ionutes/Amplificator_de_tensiune/Documentatie_P1_CEF_Dragotoniu_431C.pdf

# PROIECT 1 CIRCUITE ELECTRONICE FUNDAMENTALE

# AMPLIFICATOR DE TENSIUNE

# CU REACȚIE

PROFESORI COORDONATORI: Ș. I. Dr. Ing. Miron Jean Cristea

Dr. Ing. Niculina Drăghici

## STUDENT: DRAGOTONIU IONUȚ-CONSTANTIN

## GRUPA 431C

## CUPRINS

1. Tema proiectul | pag. 3
2. Schema bloc | pag. 3
3. Schema electrica | pag. 4
4. Detalii de proiectare | pag. 4
4.1. Etajul diferential | pag. 6
4.2. Etajul emitor comun degenerat | pag. 6
4.3. Etajul de iesire in clasa AB | pag. 7
4.4. Sursa de curent | pag. 8
4.5. Oglinda de curent | pag. 8
5. Functionalitatea circuitului | pag. 9
6. Punctul static de functionare | pag. 10
7. Amplificarea in bucla inchisa | pag. 15
8. Amplificarea in bucla deschisa | pag. 16
9. Impedanta de intrare | pag. 18
10. Analiza domeniului temperaturilor de functionare | pag. 19
11. Bill of materials (BOM) | pag. 19
12. Bibliografie | pag. 20

### 1. CERINȚELE PROIECTULUI (pentru N=2):

Obiectivul este proiectarea și realizarea practică a unui amplificator de tensiune cu următorii parametri:

- Câștig în tensiune: Av = 3 +

2
2

= 4

- Semnal intrare: sinusoidă cu amplitudinea de 100mVv-v și frecvența 1kHz .
- Impedanță la intrare: 100kΩ .
- Sarcină la ieșire: rezistență de 10Ω .
- Regim termic: funcționare între 0-70°C (validată prin teste);
- Amplificare în buclă deschisă: valoare minimă de 200;
- Circuitul va fi alimentat la o sursă de tensiune curentă.
- Se folosesc componente discrete, nu se folosesc circuite integrate.

### 2. SCHEMA BLOC A CIRCUITULUI

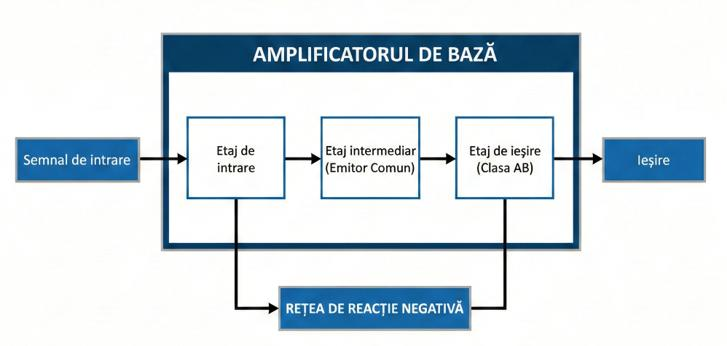
[picture p1: figure]

3.SCHEMA ELECTRICULUI (ÎN BUCLĂ ÎNCHISĂ)

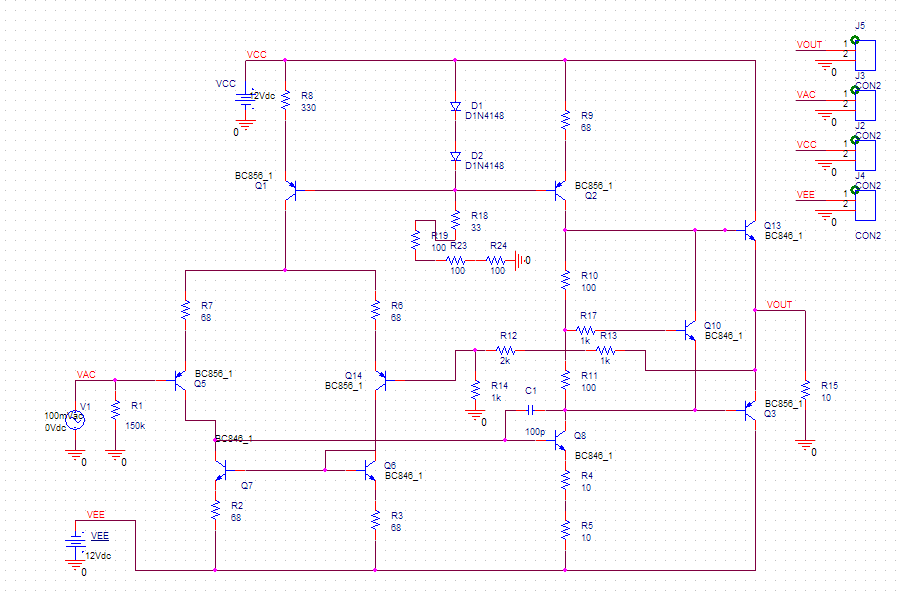
[picture p2: figure]

### 4. DETALII DE PROIECTARE

Circuitul realizat este un amplificator de joasă frecvență cu reacție negativă de tip serie-paralel. Arhitectura generală este compusă din amplificatorul de bază și rețeaua de reacție.

Amplificatorul de bază este structurat, la rândul său, pe trei etaje principale de amplificare:

- Etajul de intrare: realizat cu un amplificator diferențial;
- Etajul intermediar: configurat ca emitor comun degenerat;
- Etajul de ieșire: funcționând în clasa AB.

Pentru asigurarea punctelor statice de funcționare, amplificatorul de bază integrează și două blocuri auxiliare esențiale:

- Sursa de curent;
- Oglinda de curent.

În figura următoare au fost evidențiate toate etajele :

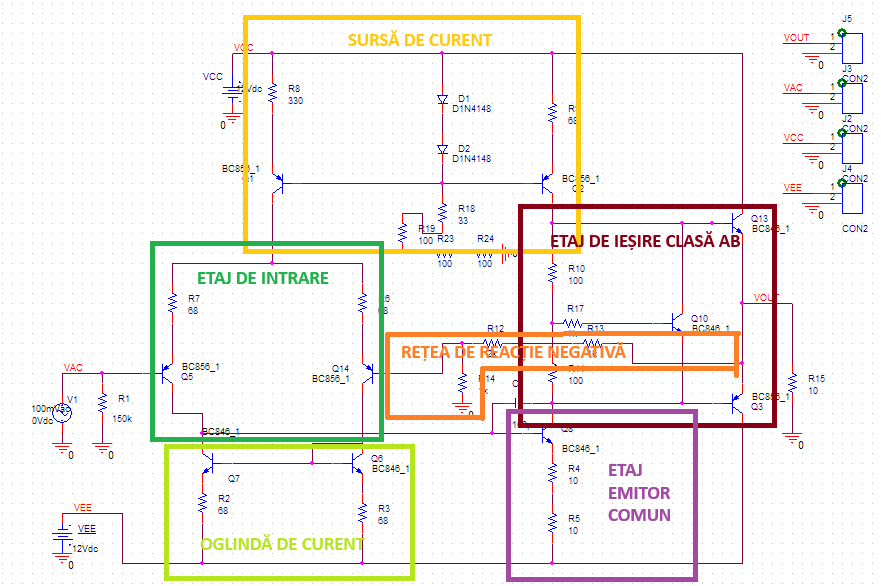
[picture p3: figure]

Mai jos sunt prezentate rolurile pentru fiecare bloc care intră în construcția amplificatorului:

### 4.1. ETAJUL DIFERENȚIAL

Etajul de intrare este configurat sub forma unui amplificator diferențial. Acest montaj electronic utilizează două intrări pentru a procesa și amplifica exclusiv diferența de potențial dintre semnalele aplicate, oferind un câștig ridicat pentru modul diferențial.

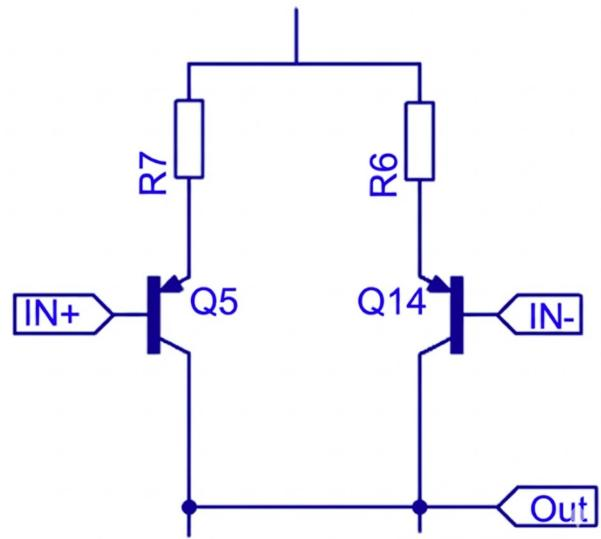
[picture p4: figure]

În schema amplificatorului, etajul diferențial este format din tranzistoarele PNP Q5 și Q14 (de tipul BC856B) și rezistențele de aceeași valoare R6 = R7 = 68 Ohmi. Acest etaj este esențial pentru funcționarea circuitului și, totodată, pentru a ajunge la amplificarea dorită.

Etajul face diferența dintre tensiunea sinusoidală aplicată la intrare (în baza tranzistorului Q5) și semnalul adus în baza tranzistorului Q14 (prin intermediul reacției negative). Acesta realizează o amplificare ridicată în condiții de derivă minimă și un raport semnal-zgomot favorabil.

### 4.2. ETAJUL EMITOR COMUN DEGENERAT

Etajul intermediar este realizat printr-o configurație emitor comun, având rolul de a spori considerabil amplificarea semnalului. Dincolo de câștigul în tensiune, acesta îndeplinește funcția esențială de adaptare între etajul de intrare și blocul de ieșire.

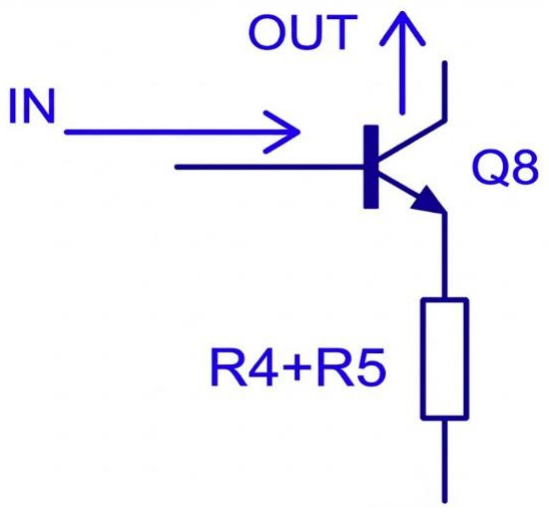
[picture p5: figure]

Etajul este considerat "degenerat" deoarece are legate și rezistențele în serie R4 și R5 de emitorul tranzistorului Q8.

### 4.3. ETAJUL DE IEȘIRE ÎN CLASĂ AB

Configurația de clasă AB a etajului de ieșire este aleasă pentru a contracara ambalarea termică. Tensiunea de polarizare pentru perechea Q13–Q3 este furnizată de tranzistorul Q10, prin multiplicarea tensiunii sale bază-emitor Vbe10.

Din schemă putem observa că:

Vce10 = Vbe13 + Veb3

Dar, în același timp, se formează și un divizor de tensiune în baza tranzistorului Q10. Așadar, se poate scrie că:

Vbe10 = Vce10 * [ R11 / (R10 + R11) ]

Deci:

Vce10 = Vbe10 * (1 + R10/R11)

Din acest motiv am ales rezistențele R10 = R11 egale în circuit, pentru a obține Vce10 = 2 * Vbe10. Astfel, forțăm tranzistoarele Q13 și Q3 să lucreze în RAN (Regim Activ Normal),

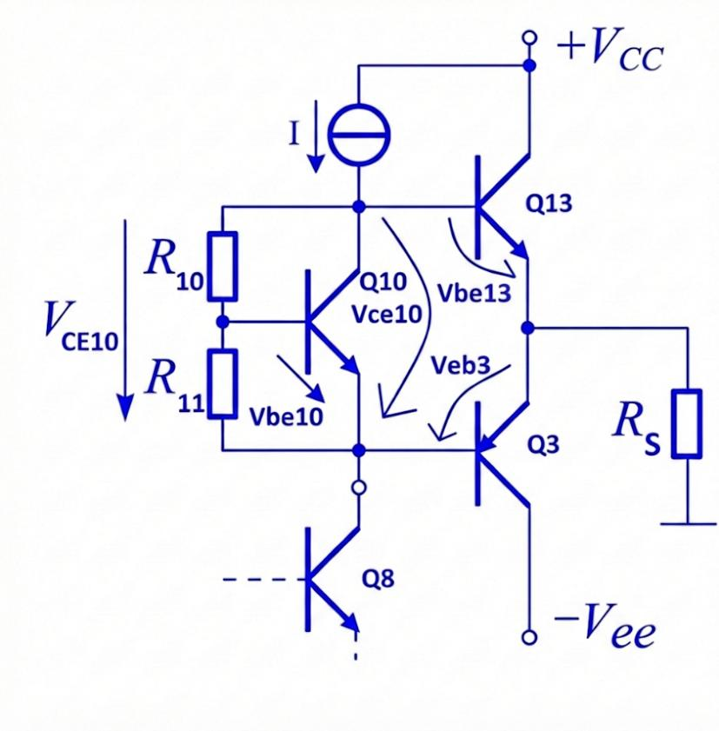
[picture p6: figure]

considerând că tranzistoarele au tensiunile dintre bază-emitor aproximativ egale:

2 * Vbe10 = Vbe13 + Veb3

Evitarea ambalării termice a etajului de la ieșire poate fi demonstrată astfel:

Considerăm că prin tranzistoarele Q13 și Q3 trece curentul IQ, iar prin rezistența de sarcină trece un curent neglijabil în raport cu IQ.

Știm că Vce10 = Vbe13 + Veb3 și că Vce10 = Vbe10 * (1 + R10/R11).

Concluzia matematică arată că, în final, curentul IQ nu va depinde critic de temperatură, ci doar de parametrii de model și rezistențele R10 și R11.

### 4.4. SURSA DE CURENT

Sursa de curent, împreună cu oglinda de curent, asigură echilibrarea etajului diferențial prin forțarea tranzistoarelor Q5 și Q14 să conducă curenți de valori identice.

Ic1 = (2 * Vd - Veb1) / R8

În acest caz, am notat Vd3 = Vd2 = Vd deoarece diodele D1 și D2 sunt de același tip. Totodată, sursa de curent alimentează și etajul intermediar emitor-comun cu ajutorul tranzistorului Q2.

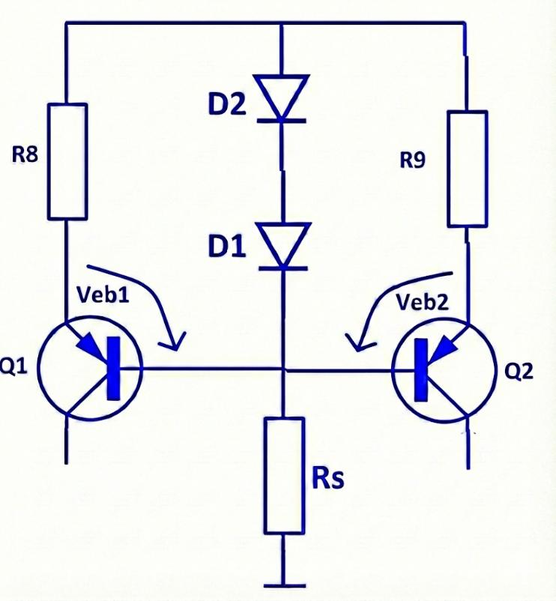
[picture p7: figure]

### 4.5. OGLINDA DE CURENT

Oglinda de curent se definește ca un repetor de curent cu schimbarea punctului de referință al sarcinii.

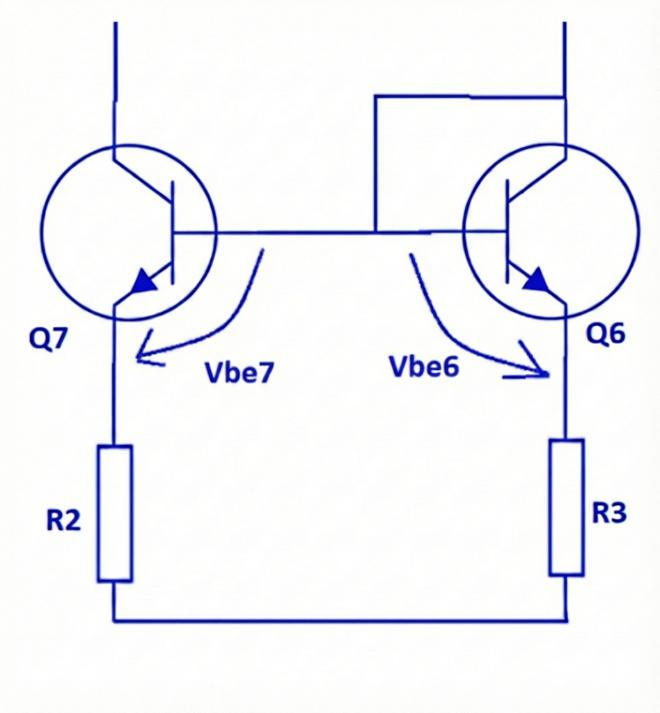
[picture p8: figure]

În schema amplificatorului, oglinda de curent este formată din tranzistoarele Q7 și Q6, care sunt de același tip. Așadar, au aceiași parametri de model, inclusiv curentul de saturație Is7 = Is6.

Dacă tranzistoarele funcționează la aceeași temperatură: Vth7 = Vth6.

Știind în plus că Vbe7 = Vbe6, atunci rezultă că Ic7 = Ic6, deci Ic5 = Ic14, în condițiile în care curenții prin bazele tranzistoarelor sunt neglijabili.

Amplificatorul diferențial împreună cu oglinda de curent oferă performanțe mult mai bune.

### 5. FUNCȚIONALITATEA CIRCUITULUI

La intrarea circuitului se aplică un semnal sinusoidal cu frecvența de 1kHz și o amplitudine vârf-la-vârf de 100mV. Impedanța de intrare este determinată în principal de rezistența R12.

Pentru a respecta cerința de proiectare (o impedanță de intrare de 100 kOhmi), a fost selectată o rezistență de 150 kOhmi. Justificarea acestei alegeri se bazează pe faptul că impedanța totală de intrare este echivalentul paralel dintre R1 și rezistența de intrare în baza
tranzistorului Q5.

Deoarece impedanța în baza lui Q5 este foarte mare (de ordinul MOhmi), contribuția sa în paralel este neglijabilă, valoarea finală fiind dictată practic de R1.

Pentru a asigura o amplificare în buclă deschisă de peste 200, s-au ales tensiuni de alimentare de ±12V.
Polarizarea etajului de intrare

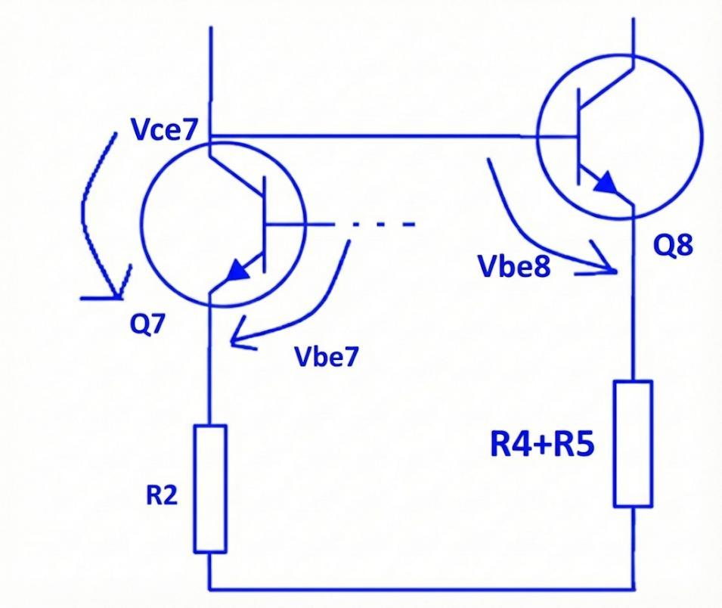
[picture p9: figure]

este realizată prin sursa de curent Q1, care impune curenți egali și constanți prin tranzistoare: Ic5 = Ic14 = 1.4 mA.

Tranzistoarele Q7 și Q6 formează o oglindă de curent, având rolul de a forța egalitatea curenților din etajul diferențial. Pentru menținerea tranzistoarelor Q5 și Q14 în Regiunea Activă Normală (RAN), sunt utilizate diodele D1 și D2.

După etajul diferențial cu ieșire asimetrică, semnalul trece într-un etaj de tip emitor comun degenerat, construit în jurul tranzistorului NPN Q8.

Curentul de colector al acestuia (12.8mA) este furnizat de o a doua sursă de curent, realizată cu tranzistorul PNP Q2.

Pentru a garanta funcționarea lui Q7 în RAN (condiția Vce7 ≥ Vbe7), este necesară o rezistență care să producă o cădere de tensiune; fără aceasta, condiția nu ar putea fi îndeplinită. Ecuația pentru acest ochi de rețea este Vce7+Vr2=Vbe8+Vr4+Vr5.

Etajul final este de clasă AB, fiind compus din tranzistoarele Q13 și Q3, prin care circulă curenți de repaus Ic13 = 6.9 mA și Ic3 = 6.9 mA. Polarizarea acestora este asigurată de tranzistorul Q10 împreună cu rezistențele R10 și R11; Q10 funcționează ca un multiplicator de tensiune bază-emitor și nu participă activ la amplificarea semnalului.În ansamblu, cele trei etaje descriu arhitectura internă a unui amplificator operațional.

Circuitul este stabilizat printr-o buclă de reacție negativă formată din R12, R13 și R14, care preia semnalul de la ieșire și îl reintroduce la intrarea amplificatorului (în baza lui Q14).

A=1+(R12+R13)/R14

### 6. PUNCTUL STATIC DE FUNCȚIONARE

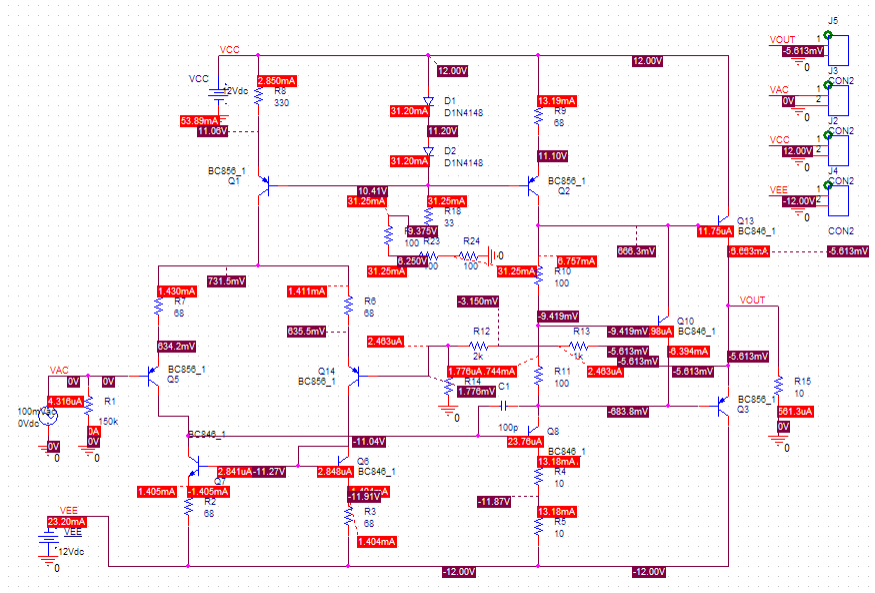
[picture p10: figure]

Q5 (Intrare): Vec5 = 10.6 V ≥ Veb5 => Q5 este în RAN
- Veb5 = 0.65V
- Ic5 = 1.4 mA
Q14 (Intrare): Vec14 = 10.6 V ≥ Veb14 => Q14 este în RAN
- Veb14 = 0.6V
- Ic14 = 1.37 mA
Q7 (Oglindă): Vce7 = 0.88 V ≥ Vbe7 => Q7 este în RAN

- Vbe7 = 0.66V
- Ic7 = 1.37 mA
Q6 (Oglindă): Vce6 = 0.65 V ≥ Vbe6 => Q6 este în RAN
- Vbe6 = 0.66V
- Ic6 = 1.36 mA
Q1 (Sursă): Vec1 = 9.3 V ≥ Veb1 => Q1 este în RAN
- Veb1 = 0.66V
- Ic1 = 2.8 mA
Q8 (EMC): Vce8 = 10 V ≥ Vbe8 => Q8 este în RAN
- Vbe8 = 0.7V
- Ic8 = 12.8 mA
Q2 (Sursă): Vec2 = 9.4 V ≥ Veb2 => Q2 este în RAN
- Veb2 = 0.7V
- Ic2 = 12.8 mA
Q13 (Ieșire): Vce13 = 11 V ≥ Vbe13 => Q13 este în RAN
- Vbe13 = 0.68V
- Ic13 = 6.9 mA
Q3 (Ieșire): Vec3 = 11 V ≥ Veb3 => Q3 este în RAN
- Veb3 = 0.68V
- Ic3 = 6.9 mA
Q10 (Ieșire): Vce10 = 1.36V ≥ Vbe10 => Q10 este în RAN
- Vbe10 = 0.68V
- Ic10 = 5.9 mA

Rezultatele simulării indică faptul că intensitatea curenților de bază este neglijabilă, având valori extrem de scăzute. Totodată, prin determinarea Punctului Static de Funcționare (PSF), am confirmat că parametrii operaționali ai fiecărei componente se încadrează în limitele de siguranță specificate în fișele tehnice (datasheets).
Exemplu de limite determinate din foile de catalog:

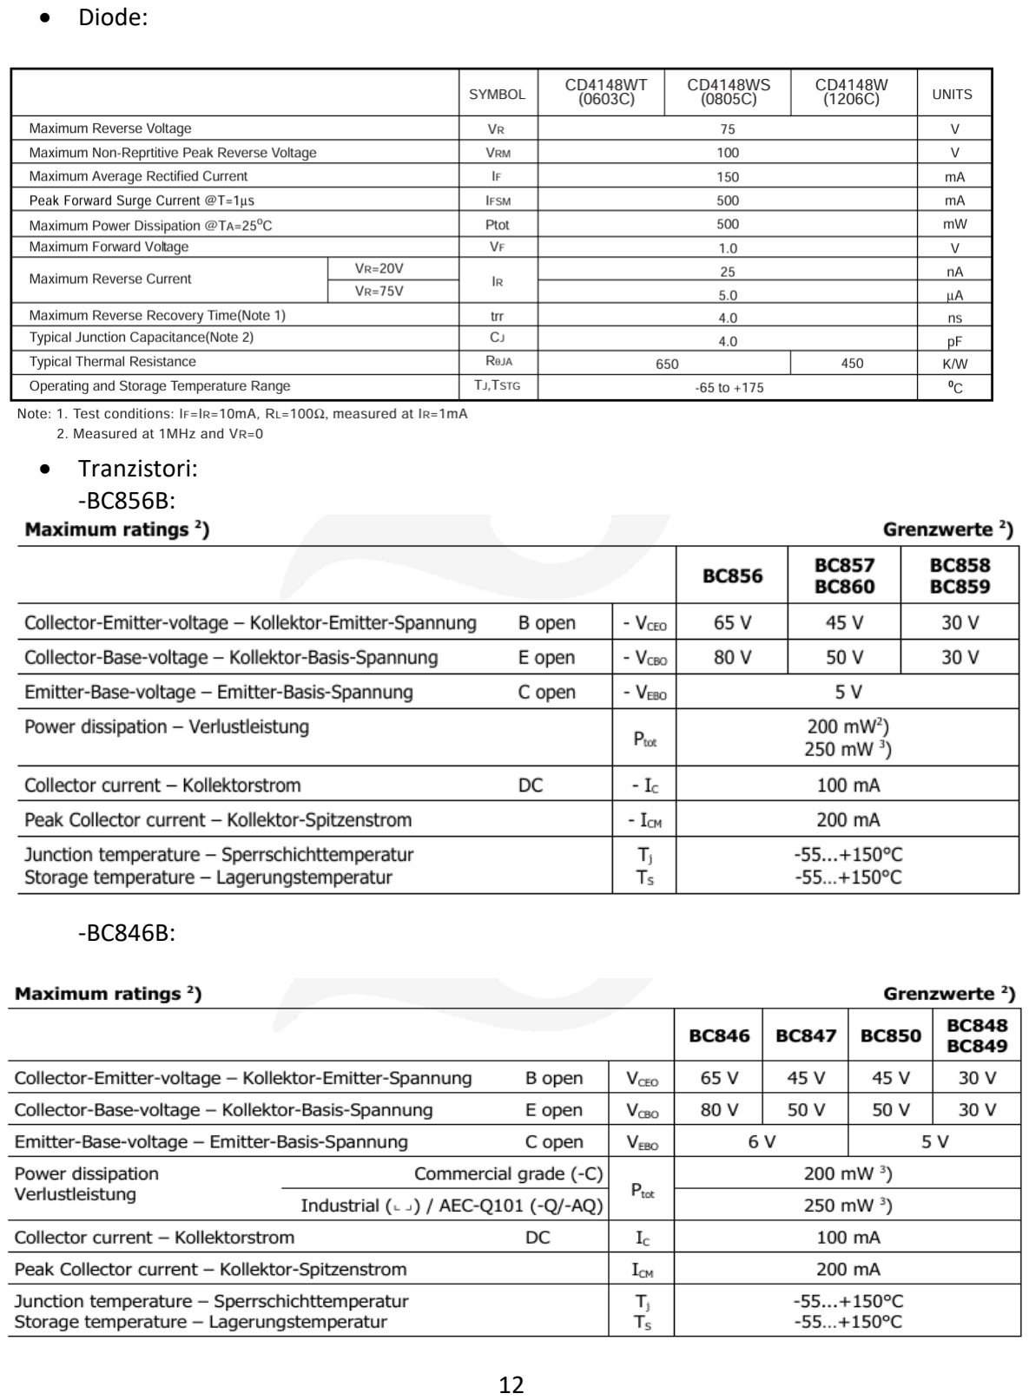
[picture p11: page 12]

- Diode:
- Tranzistori:
-BC856B:

-BC846B:

- REZISTENȚE

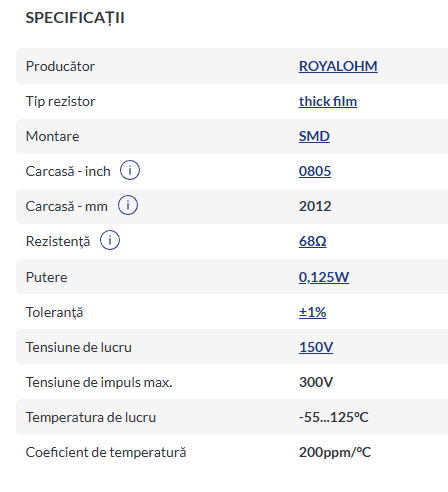
[picture p12: figure]

Verificăm și puterile electrice din circuit:

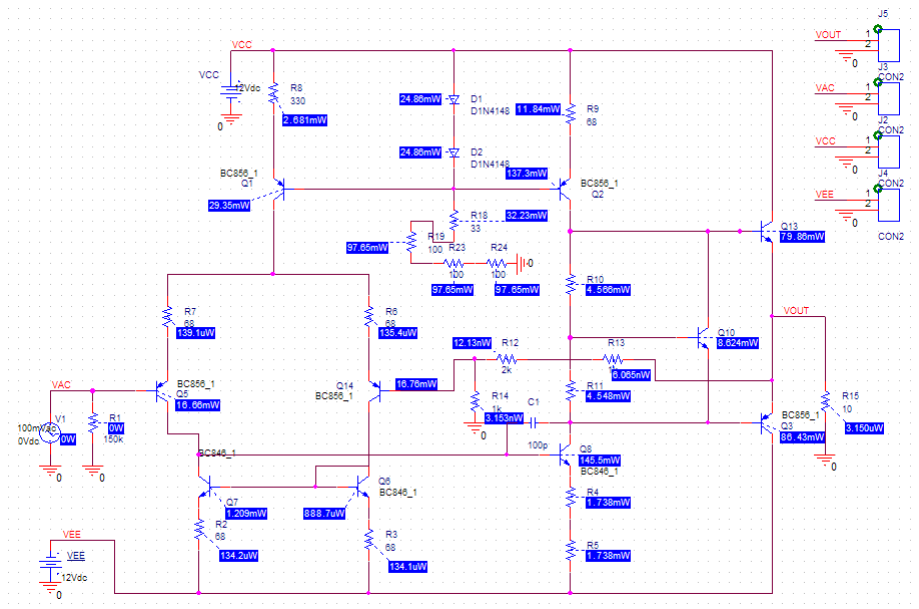
[picture p13: figure]

Se poate observa că toate componentele se impun limitelor.

7.AMPLIFICAREA ÎN BUCLĂ ÎNCHISĂ

Amplificarea în buclă închisă se calculează astfel: A=1+(R12+R13)/R14 = 4

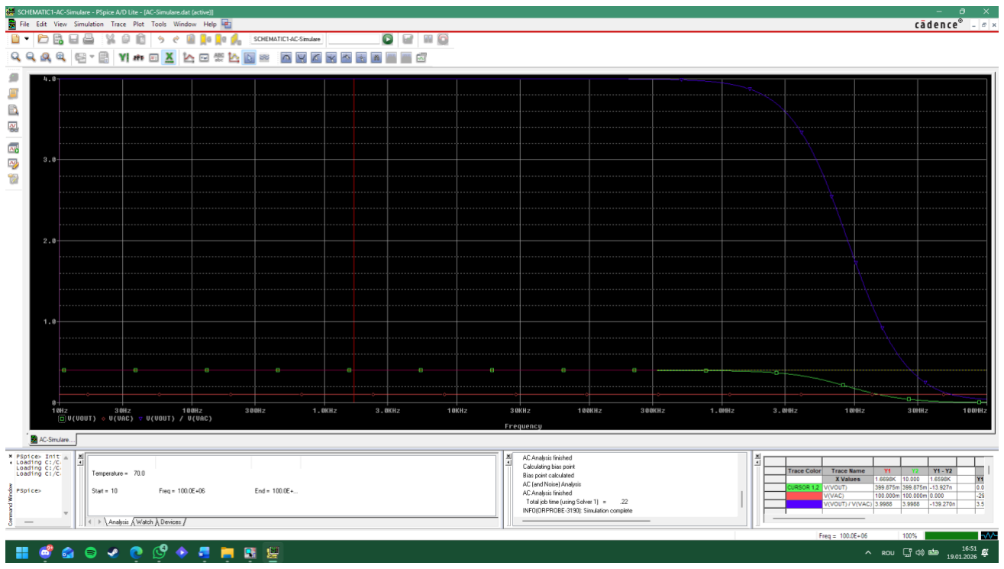
[picture p14: figure]

Mie mi-a ieșit amplificarea de 3.9988, cu o eroare de 0,03%.

8.AMPLIFICAREA ÎN BUCLĂ DESCHISĂ

Circuitul pentru amplificarea în buclă deschisă:

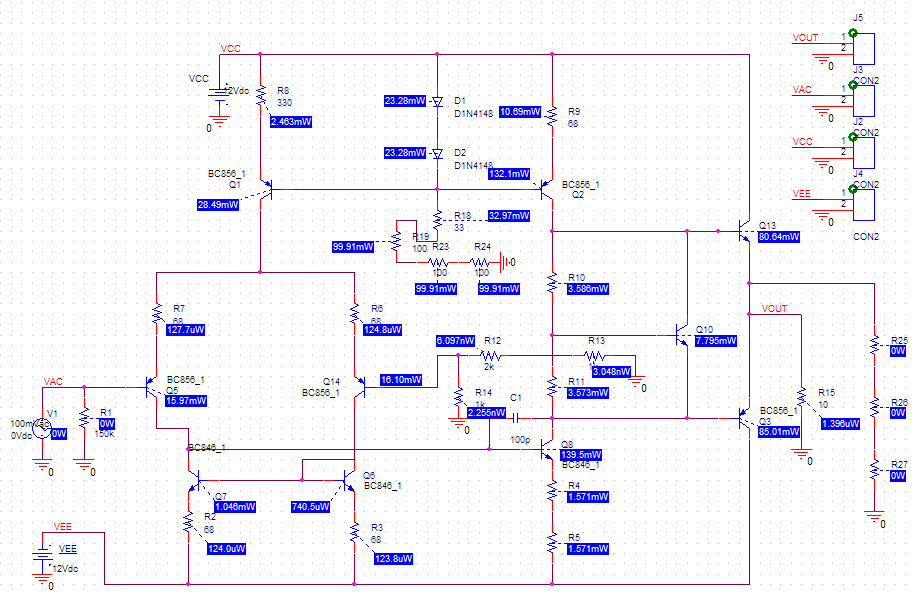
[picture p15: figure]

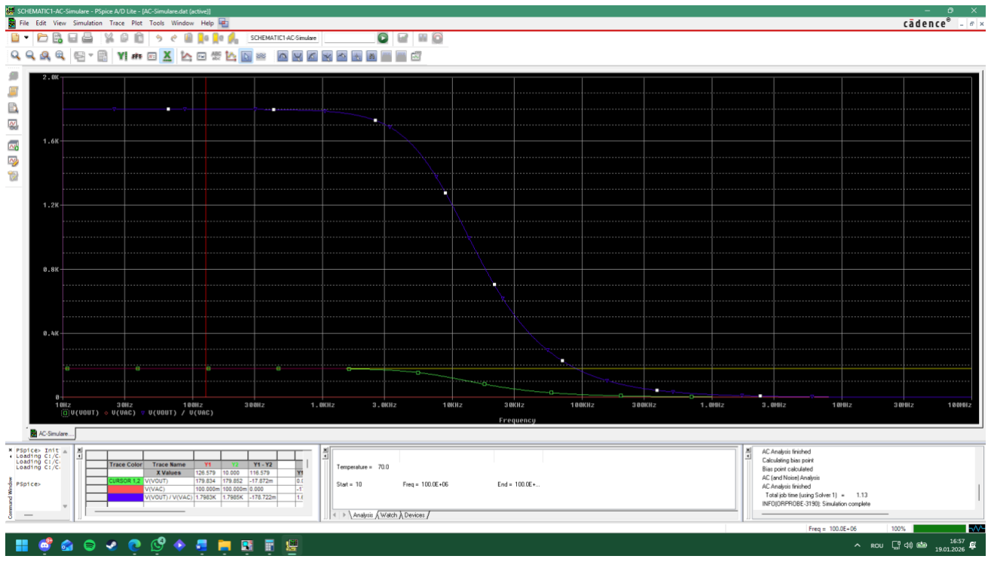
[picture p16: figure]

Se observă că s-a obținut o amplificare peste 200, mai exact 1800.

### 9. IMPEDANȚA DE INTRARE

Se dorește o impedanță de intrare mai mare ca 100kΩ, astfel a fost introdusă o rezistență R1 de 150kΩ care va intra în etajul de intrare, obținându-se astfel o impendanță de intrare de 147.386kΩ.

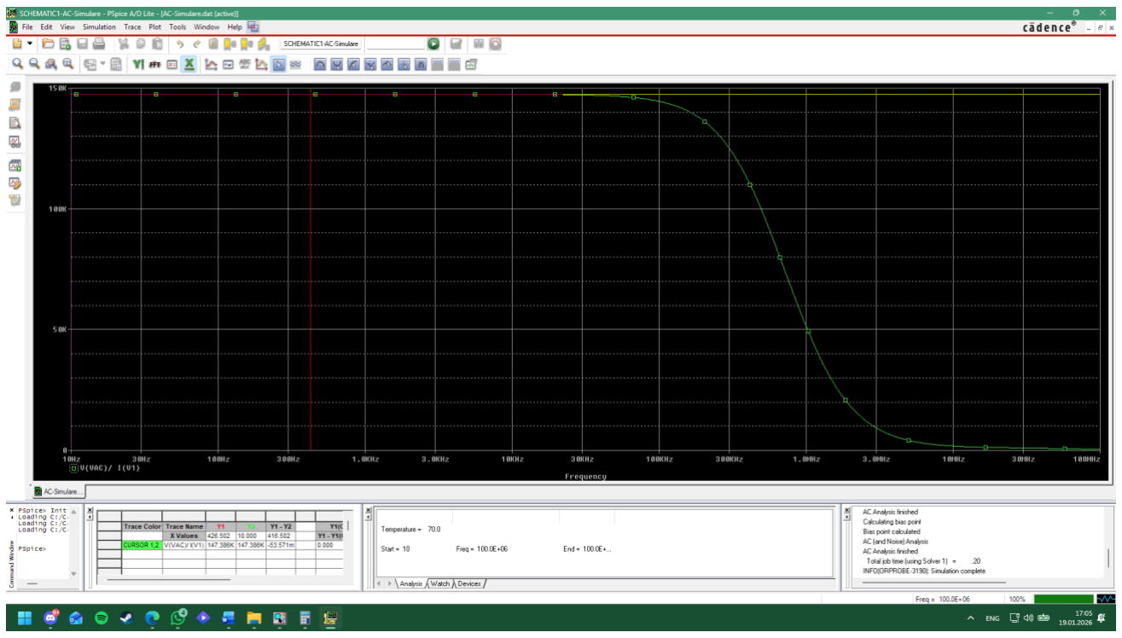
[picture p17: figure]
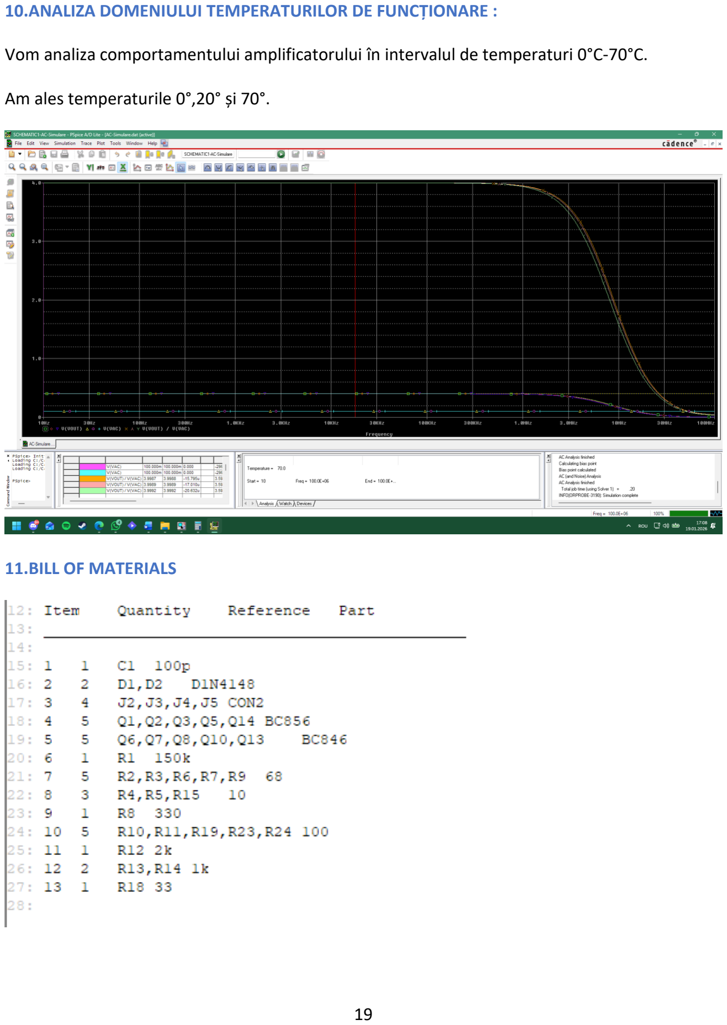
[picture p18: page 19]

10.ANALIZA DOMENIULUI TEMPERATURILOR DE FUNCȚIONARE :

Vom analiza comportamentului amplificatorului în intervalul de temperaturi 0°C-70°C.

Am ales temperaturile 0°,20° și 70°.

11.BILL OF MATERIALS

12.BIBLIOGRAFIE

- G. Brezeanu, F. Draghici, F. Mitu, G. Dilimot, Circuite electronice fundamentale, Ed. IT Grup, Bucuresti.
- https://wiki.dcae.pub.ro/
- http://www.dce.pub.ro/
