ionutes/Amplificator_de_tensiune/proiect1_test3-PSpiceFiles/SCHEMATIC1/DC/DC.cir

** Profile: "SCHEMATIC1-DC"  [ C:\Users\drago\Desktop\P1_CEF_Dragotoniu_Ionut-Constantin_431C\P1_CEF_Dragotoniu_Ionut-Constantin_431C\Fisiere PCB\proiect1_test3-pspicefiles\schematic1\dc.sim ] 

** Creating circuit file "DC.cir" 
** WARNING: THIS AUTOMATICALLY GENERATED FILE MAY BE OVERWRITTEN BY SUBSEQUENT SIMULATIONS

*Libraries: 
* Profile Libraries :
* Local Libraries :
* From [PSPICE NETLIST] section of C:\Users\drago\AppData\Roaming\SPB_Data\cdssetup\OrCAD_PSpice\17.2.0\PSpice.ini file:
.lib "nomd.lib" 

*Analysis directives: 
.OPTIONS ADVCONV
.PROBE64 V(alias(*)) I(alias(*)) W(alias(*)) D(alias(*)) NOISE(alias(*)) 
.INC "..\SCHEMATIC1.net" 


.END
