ionutes/Amplificator_de_tensiune/(list of files, drawings)

Other design files:
Fisiere PCB/PROIECT1_TEST3.DSN
Fisiere PCB/proiect1_test3.opj
