ionutes/Amplificator_de_tensiune/(commit log)

2026-03-02 Update Proiect 1 directory
    [PROIECT1_TEST3.DSN, proiect1_test3.opj]
2026-03-02 Fisiere Gerber si Drill
    [drill-1-2.drl]
2026-03-02 Folderul allegro
    [P1-CEF-DRAGOTONIU.brd, art_param.txt, cases.cfg, nc_param.txt, xsectionChartParams.txt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]
